muonTelescope/docs/images/frame/step8 rotated.png

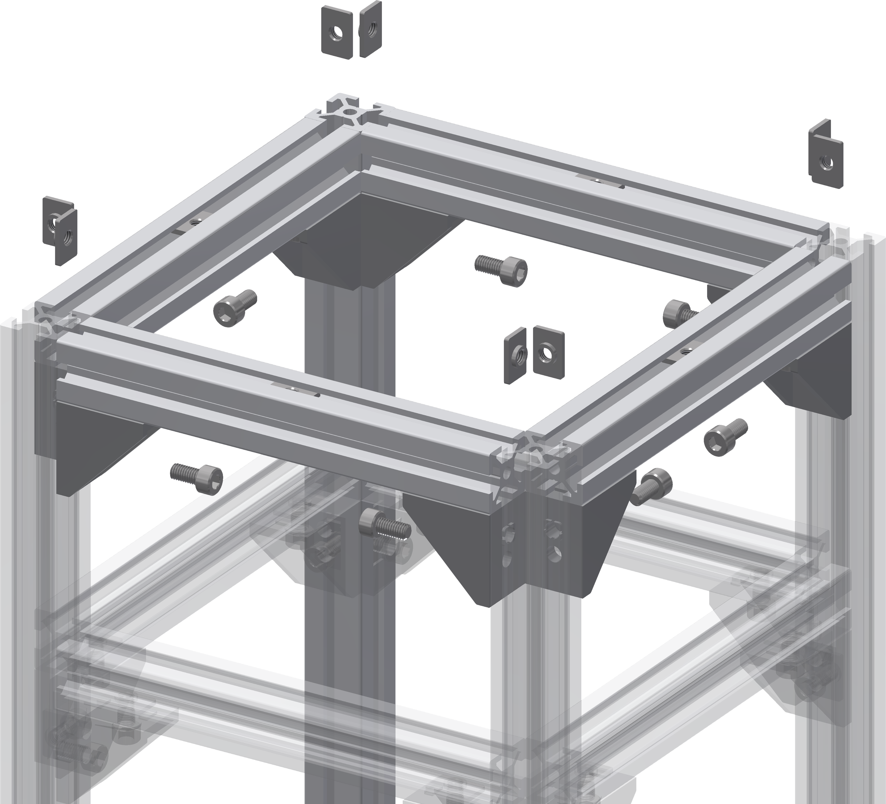
images/frame/step8 rotated.png
