muonTelescope/docs/images/frame/step10feet.png

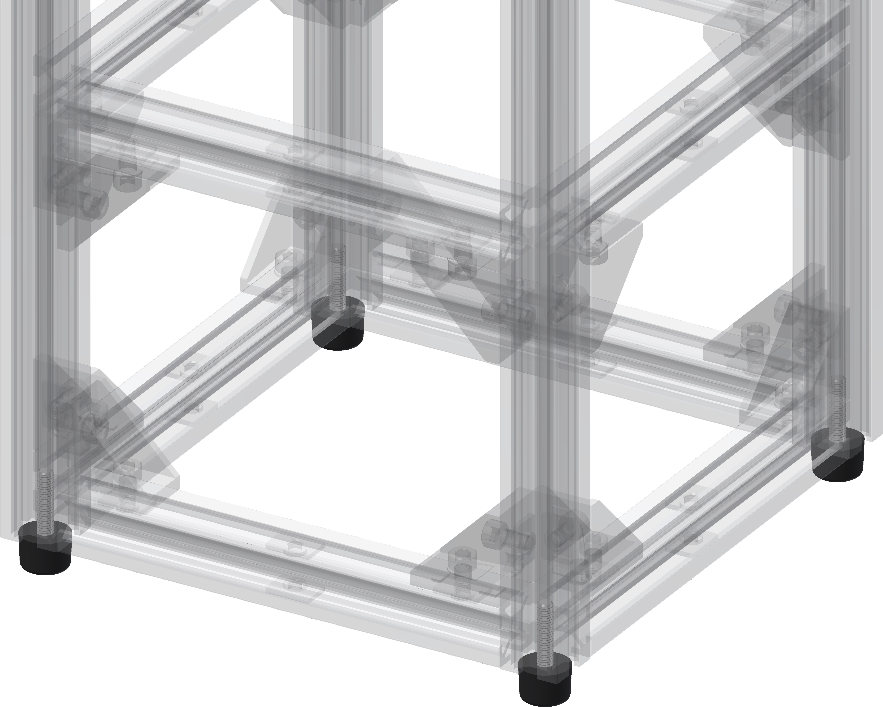
images/frame/step10feet.png
