muonTelescope/docs/tex/devTools/devTools.tex

\section{Development Tools}
The minimalist software pacakage possible are commands that can print out raw data to the terminal. The \href{https://github.com/muonTelescope/dev-tools}{dev-tools} codebase does just that. The readme for that coves how to use it.
