muonTelescope/docs/tex/frame/frame.tex

\section{Frame}

The frame is constructed out of \SI{4}{\meter} of Misumi 2020 aluminium extrution, cast angle brackets, t-nuts, M5 screws, and rubber feet. The assembly process requires only a \SI{4}{\milli\meter} hex key.

\subsection{Construction}
The frame is designed to be easy to assembly, take apart, and modify for diffrent experiments and highly rugged. It is constructed out of metric aluminium extrution and cast aluminium angle brackets, with rubber feet at the bottom. A full bill of materials is shown in Table~\ref{tab:frameBOM}. The panels it is meant to hold fit within the $\SI{20}{\milli\meter}$ extrution hegight, and the remining area is filled ithe a soft tubing spring. The panels are supourted on both sides by $\sfrac{3}{32}$ inch acrylic sheet and a addtion panel provides a mounting location for the electronics. The assembly process requires only a \SI{4}{\milli\meter} hex key, and can be made vibration resistant through the application of threadlocker (blue color code). 

\begin{table}[h]
    \centering
    \begin{adjustbox}{width=\textwidth,center}
        \begin{tabular}{ l  l  l  r  r  r }
            \multicolumn{6}{ c }{Bill of Materials} \\
            \hline
            \textbf{Description} & \textbf{Item} & \textbf{Supplier} & \textbf{QTY} & \textbf{Unit} & \textbf{Ext} \\ \hline \hline
            \product{Aluminium Extrustion}{\href{https://us.misumi-ec.com/vona2/detail/110302683830/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}{\texttt{KHFS5-2020-1000}}}{Misumi}{4}{6.41}{25.64}
            \product{Angle Brackets}{\href{https://us.misumi-ec.com/vona2/detail/110300437260/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}{\texttt{HBLFSNF5}}}{Misumi}{64}{0.63}{40.32}
            \product{M5 T-Nuts}{\href{https://us.misumi-ec.com/vona2/detail/110302246940/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}{\texttt{HNKK5-5}}}{Misumi}{$\sfrac{156}{100}$}{15.26}{23.81}
            \product{M5x6}{\href{https://www.mcmaster.com/91292a189}{\texttt{91292a189}}}{McMaster-Carr}{$\sfrac{28}{50}$}{4.63}{2.59}
            \product{M5x10}{\href{https://www.mcmaster.com/91292a124}{\texttt{91292A124}}}{McMaster-Carr}{$\sfrac{128}{100}$}{8.15}{11.20}
            \product{M5x25}{\href{https://www.mcmaster.com/91292a129}{\texttt{91292a129}}}{McMaster-Carr}{$\sfrac{4}{25}$}{6.85}{1.10}
            \product{Acrylic Sheet}{\href{https://www.mcmaster.com/8560k182}{\texttt{8560k182}}}{McMaster-Carr}{$\sfrac{7}{6}$}{8.96}{10.45}
            \product{Rubber Feet}{\href{https://www.mcmaster.com/9540K717}{\texttt{9540K717}}}{McMaster-Carr}{$\sfrac{4}{25}$}{7.42}{1.19}
            \hline
            \product{Labor}{}{}{2}{30.00}{60.00}
            \hline
            \multicolumn{5}{r}{\textbf{Subtotal}} & XXX.XX \\
            \multicolumn{5}{r}{\textbf{Tax}} & \%8.000 \\
            \multicolumn{5}{r}{\textbf{Transport}} & \%XX.XX \\
            \multicolumn{5}{r}{\textbf{Total (USD)}} & 189.24 \\
        \end{tabular}
    \end{adjustbox}
    \caption{Materials required for one frame.}
    \label{tab:frameBOM}
\end{table}

\begin{table}[h]
    \centering
    \begin{adjustbox}{width=\textwidth,center}
        \begin{tabular}{ l r r l }
            \multicolumn{4}{ c }{Aluminum Extrustion Cut List} \\
            \hline
            \textbf{Description} & \textbf{QTY} & \textbf{Length (mm)} & \textbf{Note}\\ \hline \hline
            Vertical Beam        & 4            & 396                  & M5 thread tapped one end \SI{20}{\milli\meter} deep\\
            Horizontal Beam      & 16           & 150 \\
        \end{tabular}
    \end{adjustbox}
    \caption{One vertical and four horizontal to be cut from each \SI{1}{\meter} section. \SI{1}{\milli\meter} kerf.}    
    \label{tab:cutList}
\end{table}

\subsubsection{Assembly}
Insert assembly PDF output form Illistrator

\pagebreak
