muonTelescope/docs/images/frame/16x.png

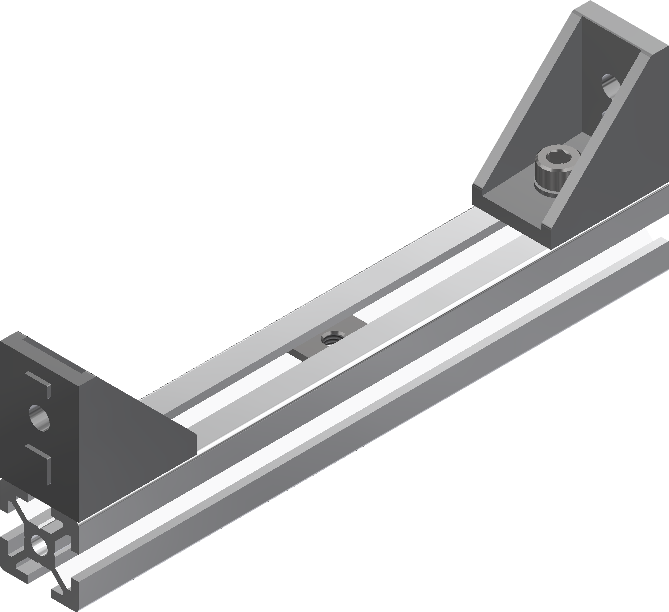
images/frame/16x.png
