muonTelescope/docs/images/frame/150mm.png

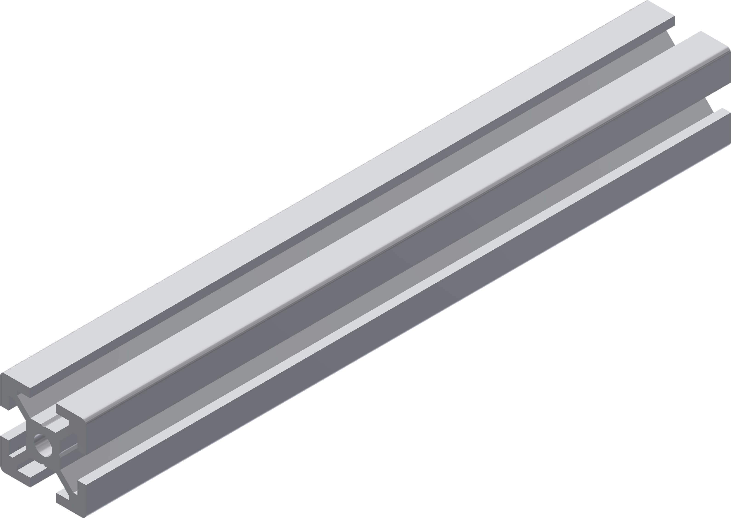
images/frame/150mm.png
