muonTelescope/docs/images/frame/400mm.png

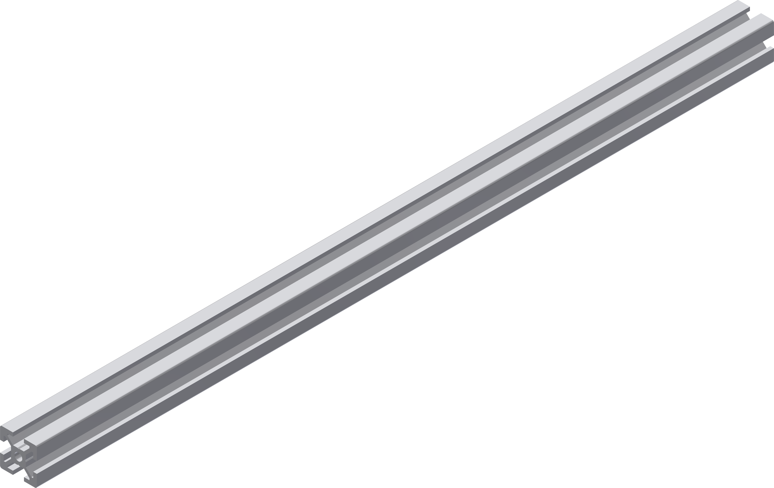
images/frame/400mm.png
