muonTelescope/docs/images/frame/angleBracket.png

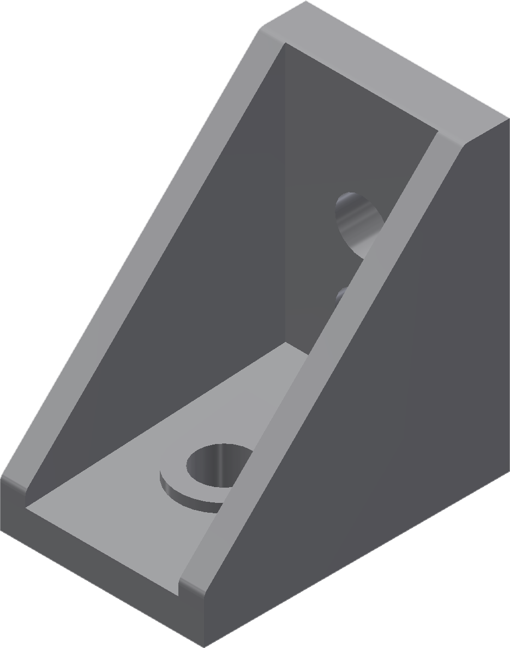
images/frame/angleBracket.png
