muonTelescope/docs/images/frame/m5x6.png

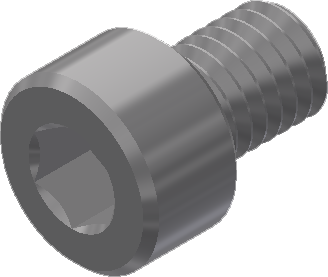
images/frame/m5x6.png
