muonTelescope/docs/images/frame/m5x10.png

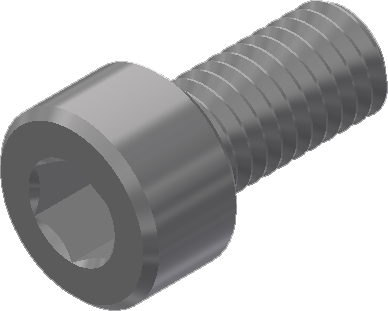
images/frame/m5x10.png
