muonTelescope/docs/images/frame/m5x25.png

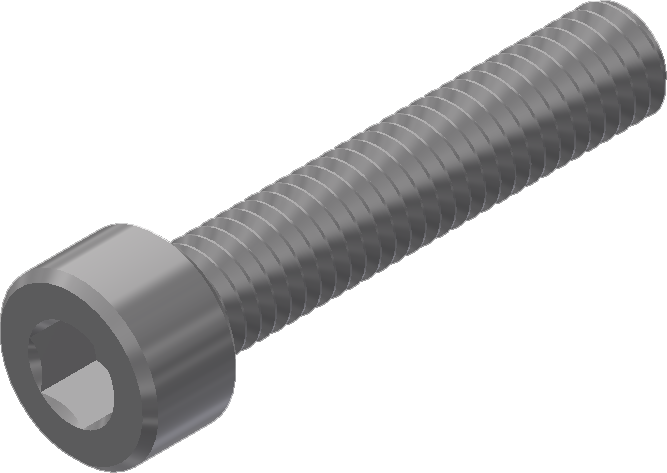
images/frame/m5x25.png
