muonTelescope/docs/images/frame/rubberFoot.png

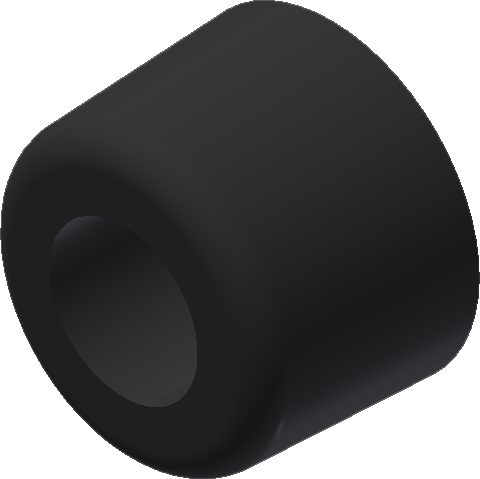
images/frame/rubberFoot.png
