muonTelescope/docs/images/frame/t-nut.png

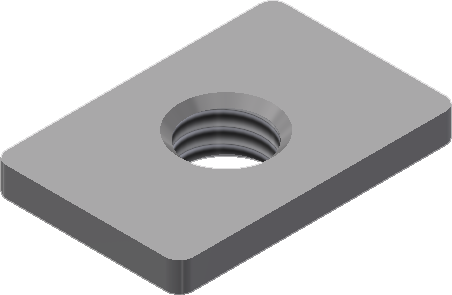
images/frame/t-nut.png
