muonTelescope/docs/images/frame/tools.png

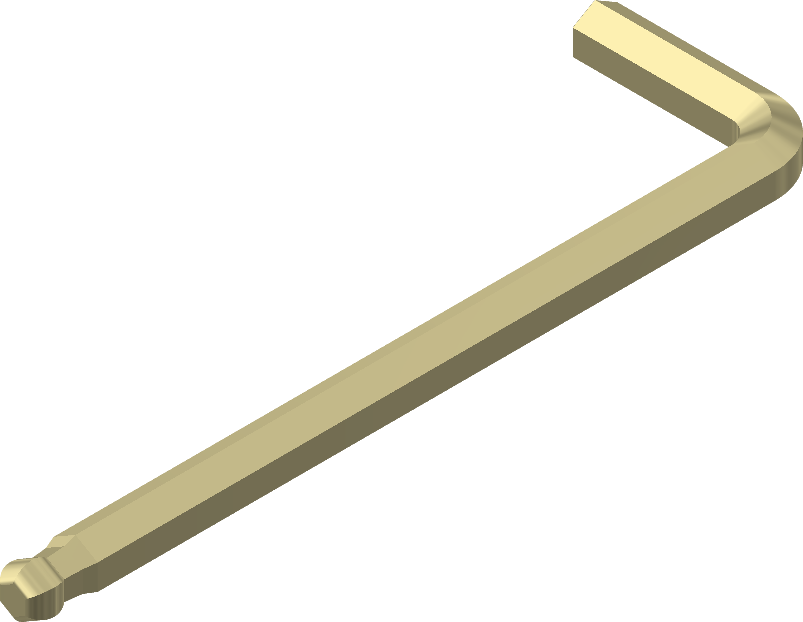
images/frame/tools.png
