muonTelescope/docs/images/mppcInterfaceDocs/11mm standoff.png

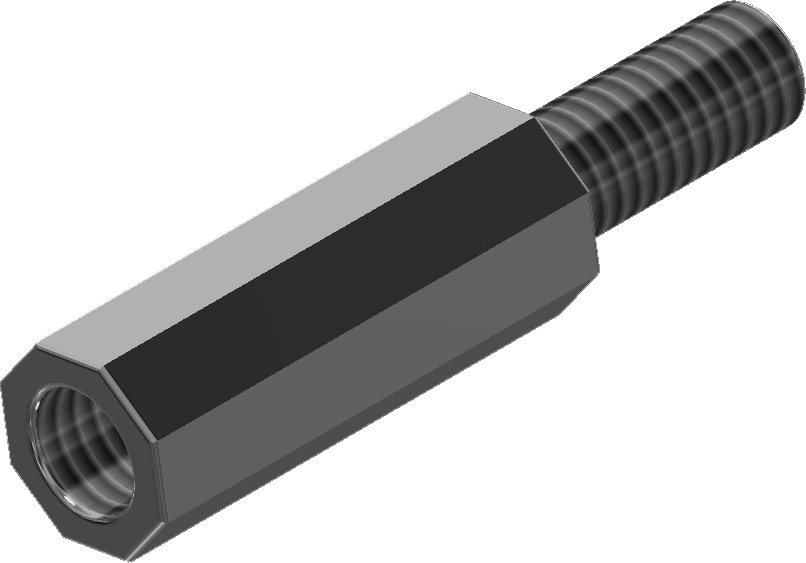
images/mppcInterfaceDocs/11mm standoff.png
