muonTelescope/docs/images/mppcInterfaceDocs/m2.5.png

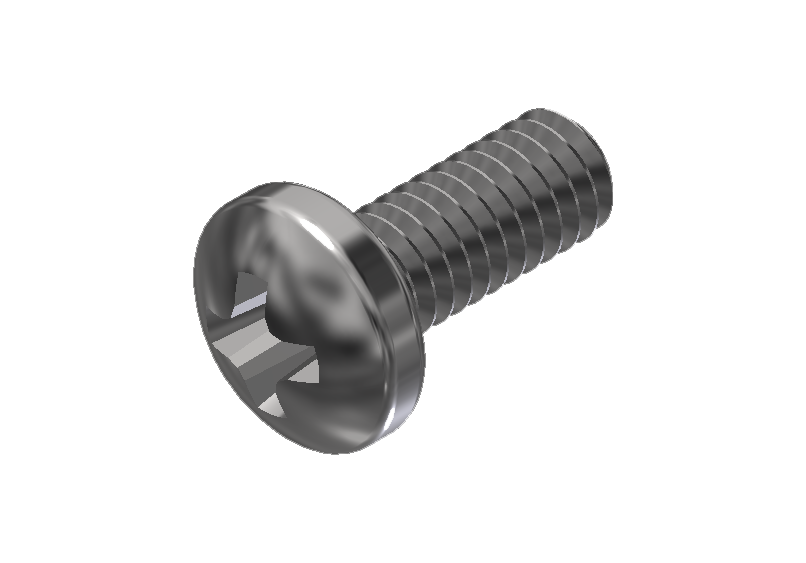
images/mppcInterfaceDocs/m2.5.png
