muonTelescope/docs/images/mppcInterfaceDocs/mppcInterfacePart.png

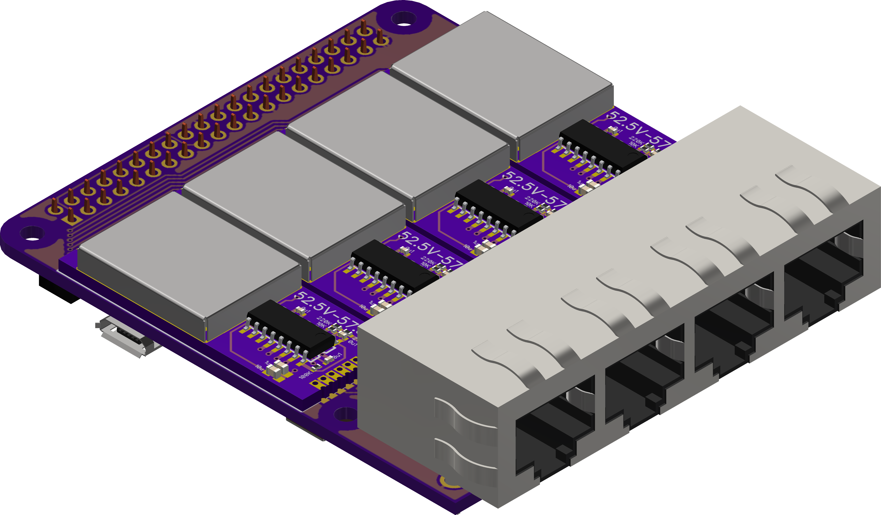
images/mppcInterfaceDocs/mppcInterfacePart.png
