muonTelescope/docs/images/mppcInterfaceDocs/mppcInterfaceSheildAttach.png

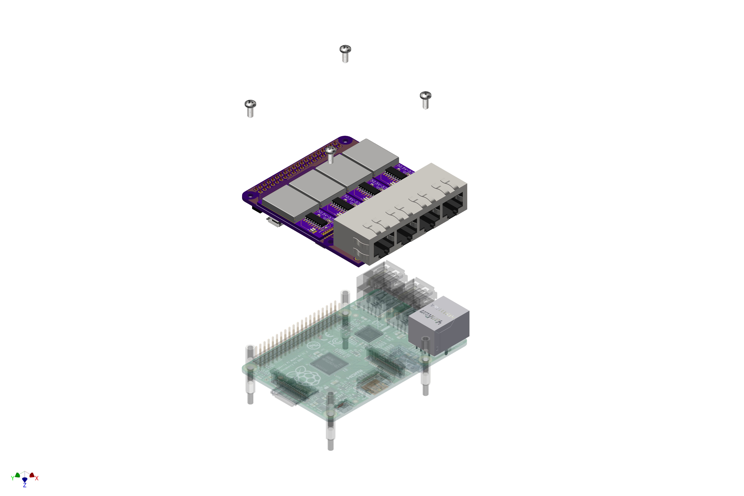
images/mppcInterfaceDocs/mppcInterfaceSheildAttach.png
