muonTelescope/docs/images/mppcInterfaceDocs/mppcInterfaceSubmodule.png

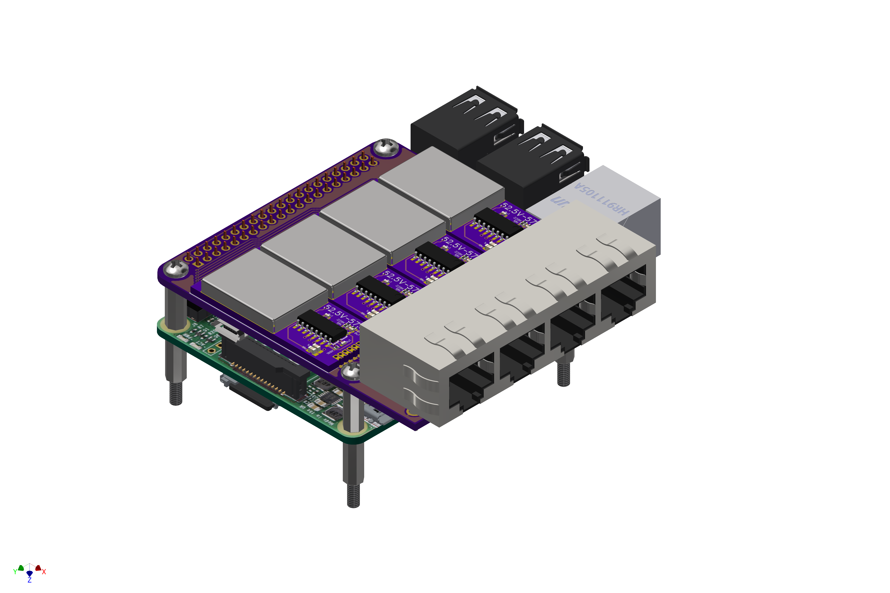
images/mppcInterfaceDocs/mppcInterfaceSubmodule.png
