muonTelescope/docs/images/mppcSensor/mppcSensorPinout-01.png

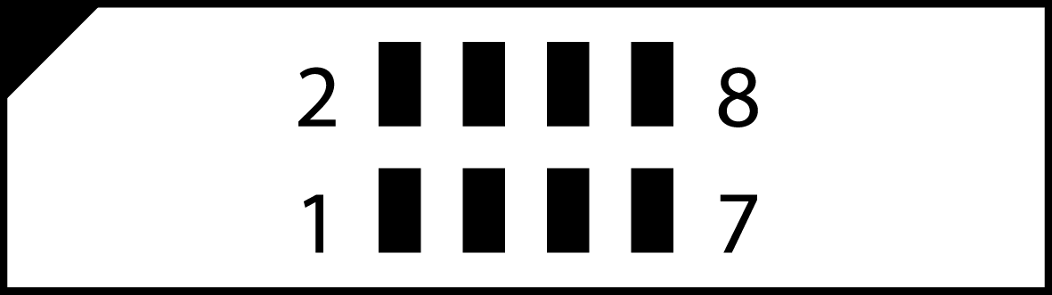
images/mppcSensor/mppcSensorPinout-01.png
