muonTelescope/docs/tex/mppcHighVoltage/img/errorFromDesign.png

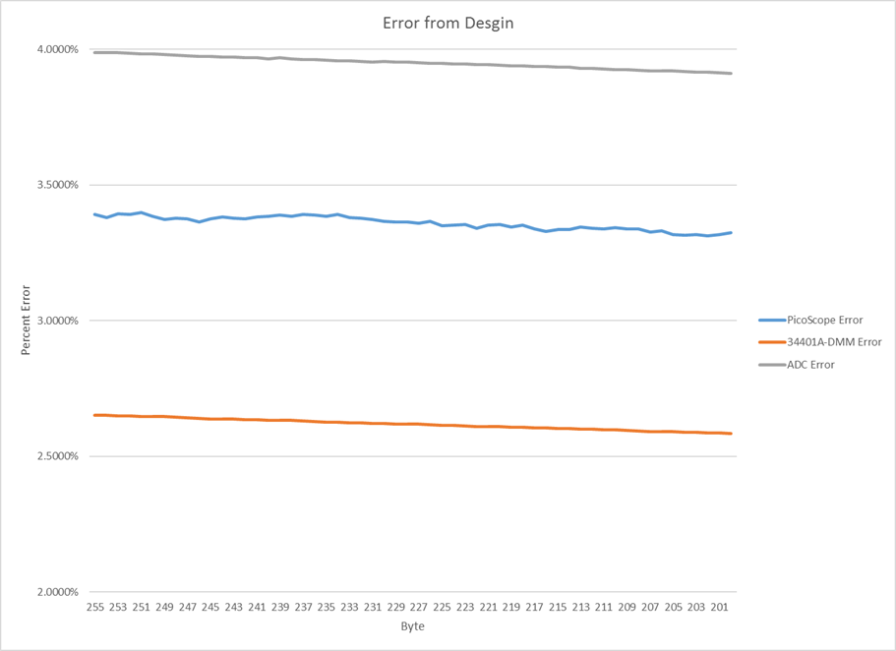
tex/mppcHighVoltage/img/errorFromDesign.png
