muonTelescope/docs/tex/mppcHighVoltage/img/hvSchematic.jpg

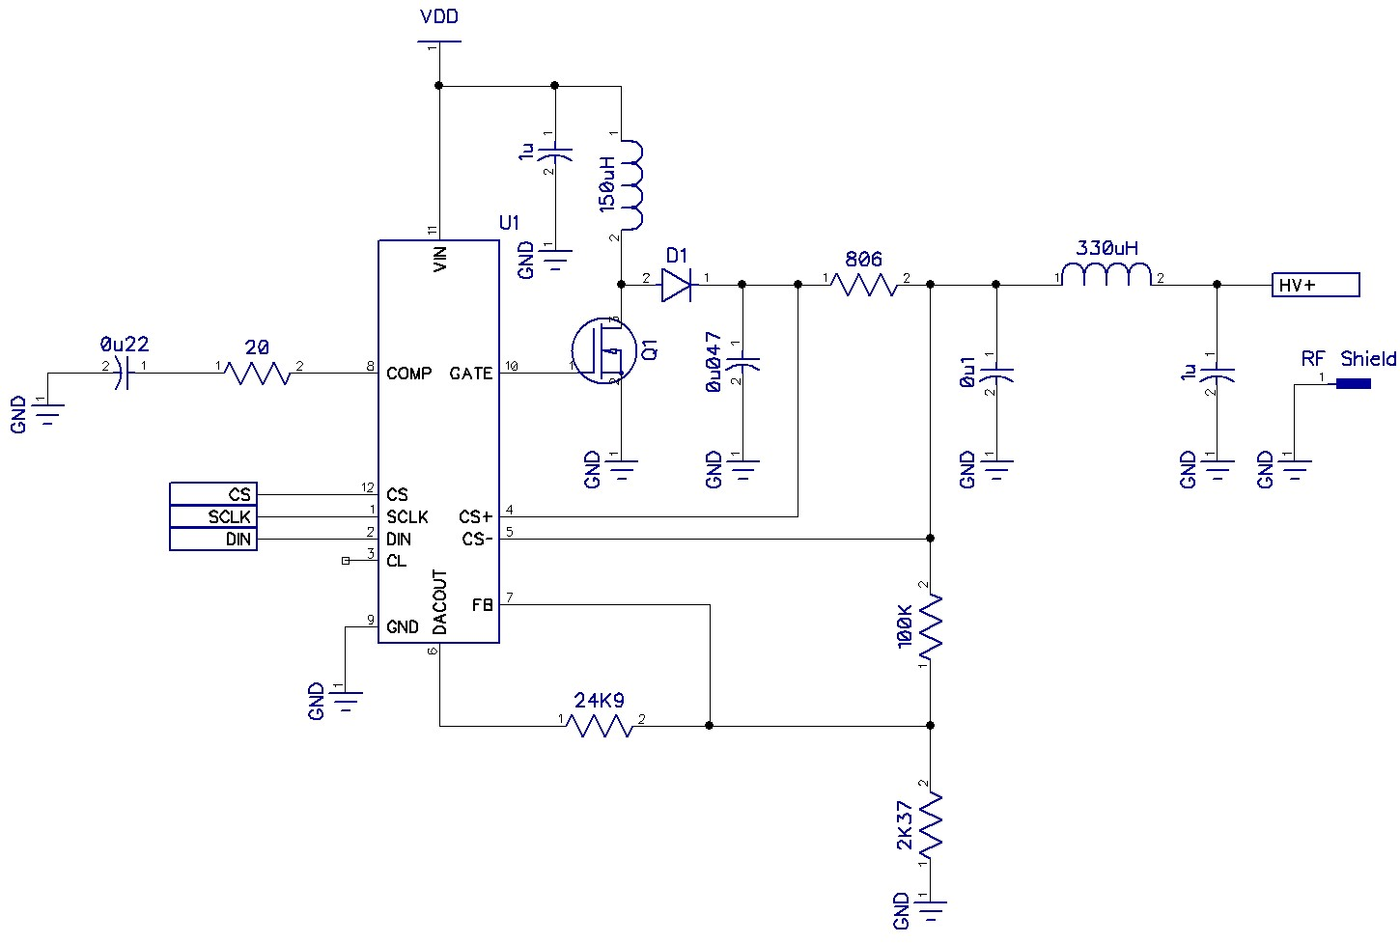
tex/mppcHighVoltage/img/hvSchematic.jpg
