muonTelescope/docs/tex/mppcHighVoltage/img/voltageVsByte.png

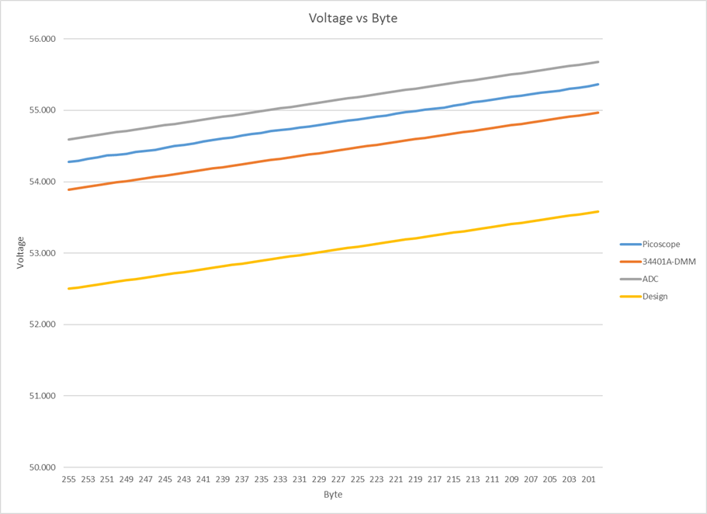
tex/mppcHighVoltage/img/voltageVsByte.png
