muonTelescope/docs/tex/mppcSensor/img/connectorsSchematic.jpg

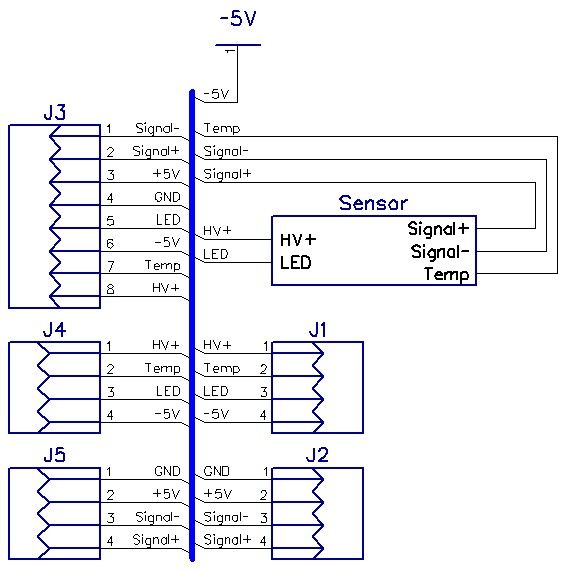
tex/mppcSensor/img/connectorsSchematic.jpg
