muonTelescope/docs/tex/mppcSensor/img/sensorSchematic.jpg

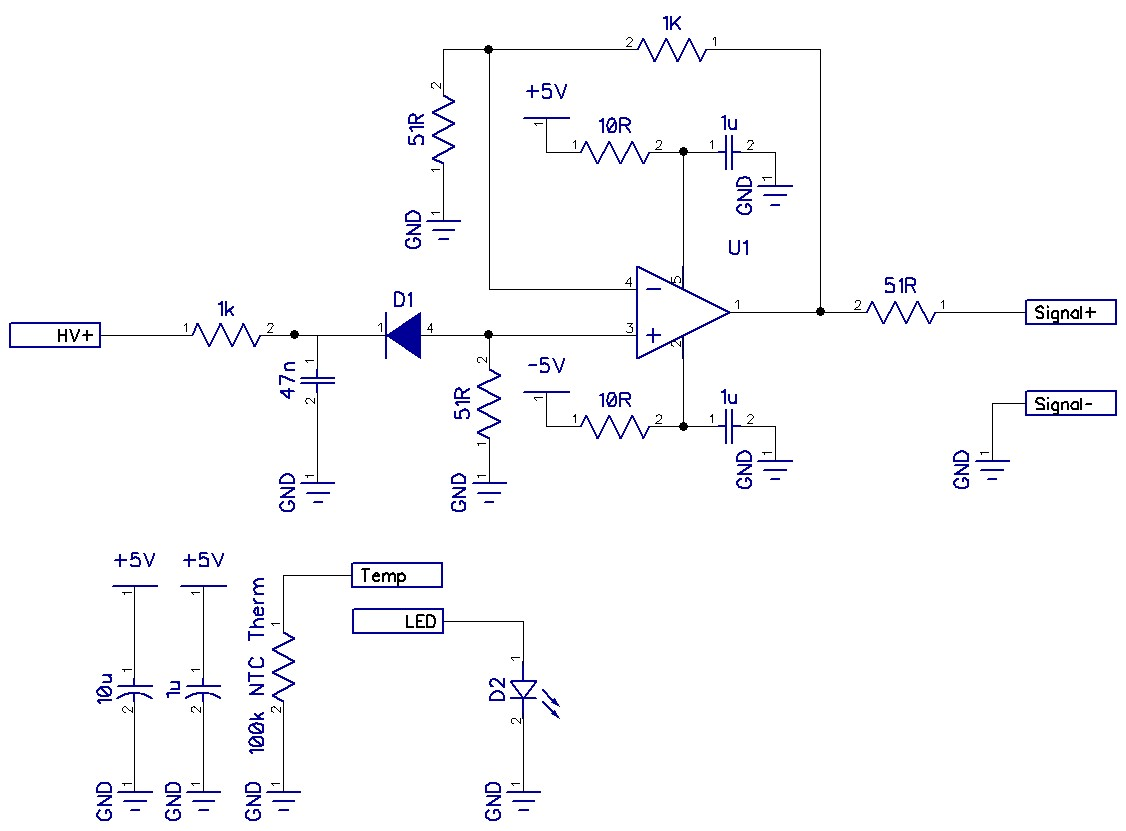
tex/mppcSensor/img/sensorSchematic.jpg
