muonTelescope/docs/images/frame/parts.png

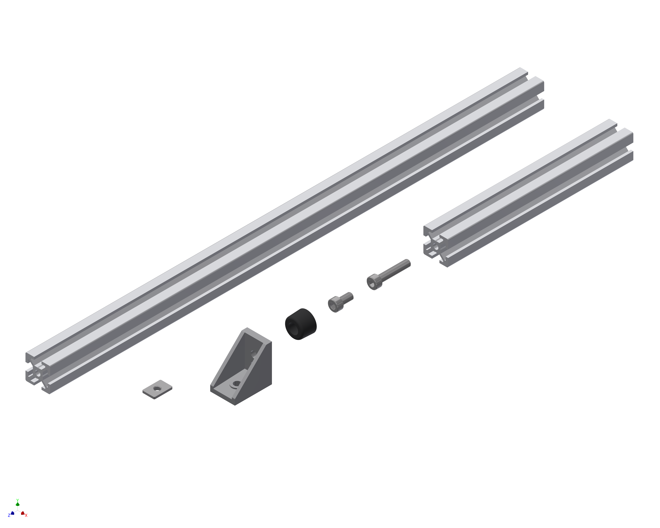
images/frame/parts.png
