muonTelescope/docs/tex/assembly/assembly.tex

\includepdf[pages={ - }]{./tex/assembly/mppcInterfaceAssembly.pdf}
\includepdf[pages={ - }]{./tex/assembly/frameAssembly.pdf}
