muonTelescope/docs/tex/assembly/mppcInterfaceAssembly.pdf

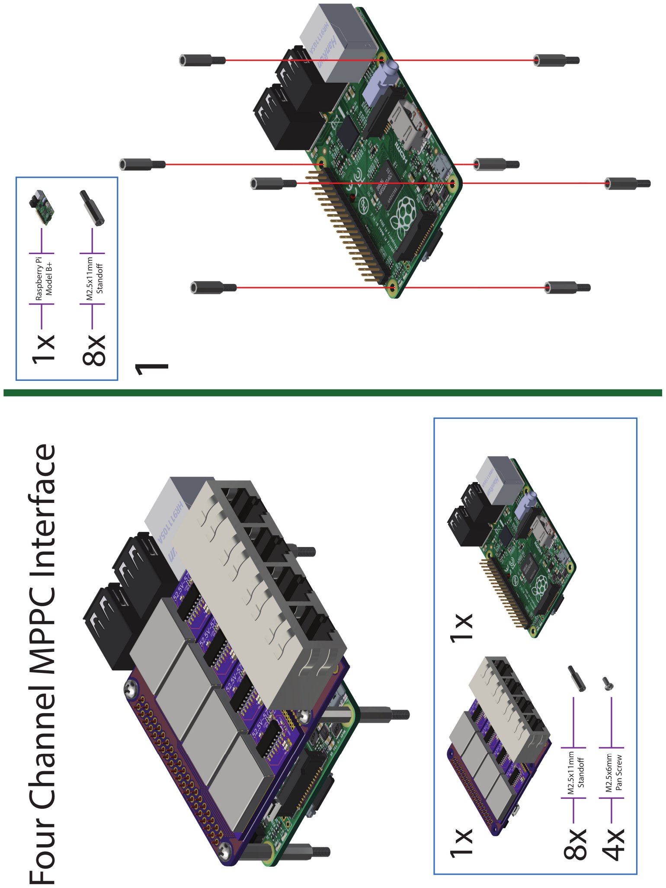
[picture p25: page 1]
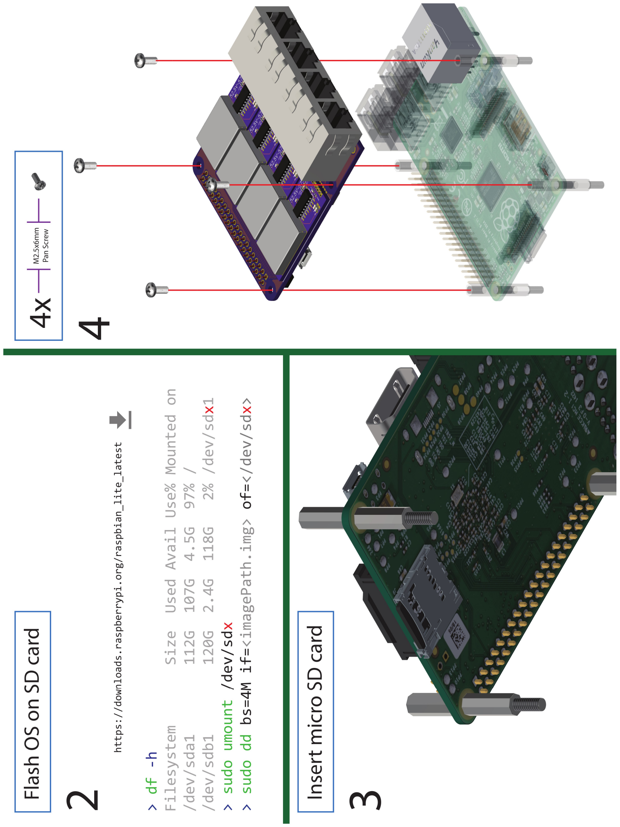
[picture p26: page 2]
