muonTelescope/docs/images/assembled2.png

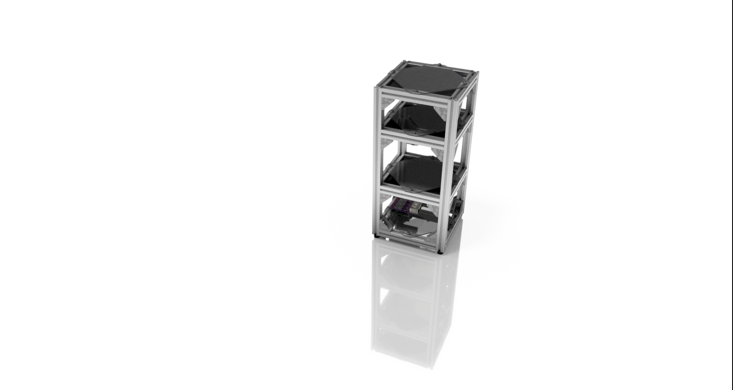
images/assembled2.png
