muonTelescope/docs/images/frame/step1.png

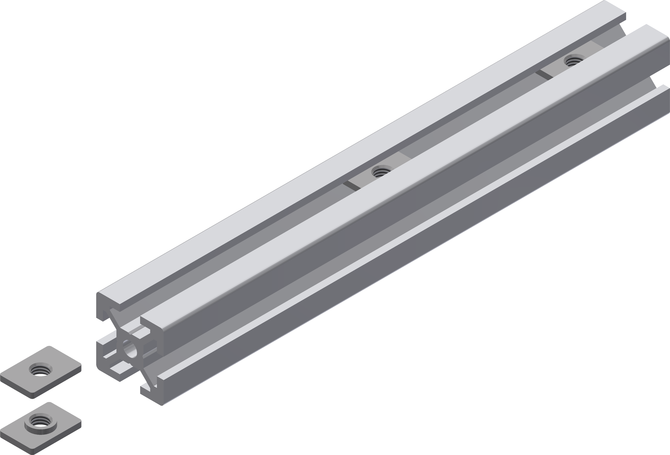
images/frame/step1.png
