muonTelescope/docs/images/frame/step2.png

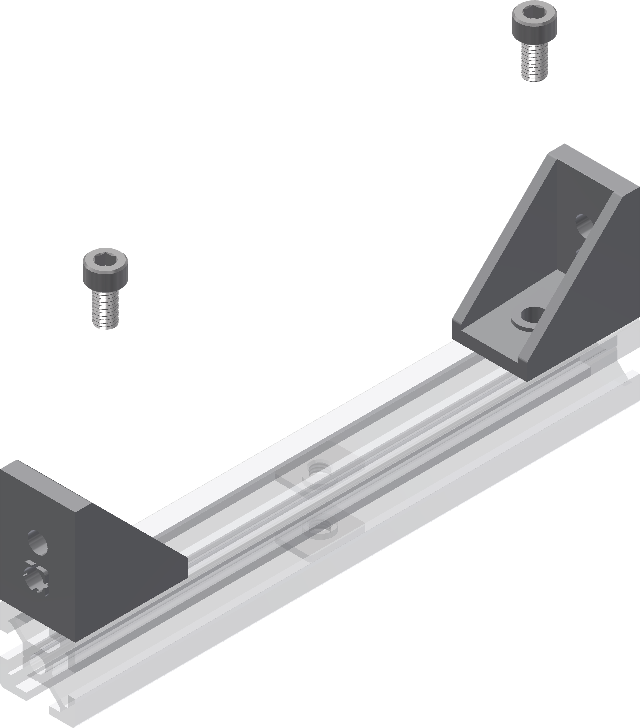
images/frame/step2.png
