muonTelescope/docs/images/frame/step3.png

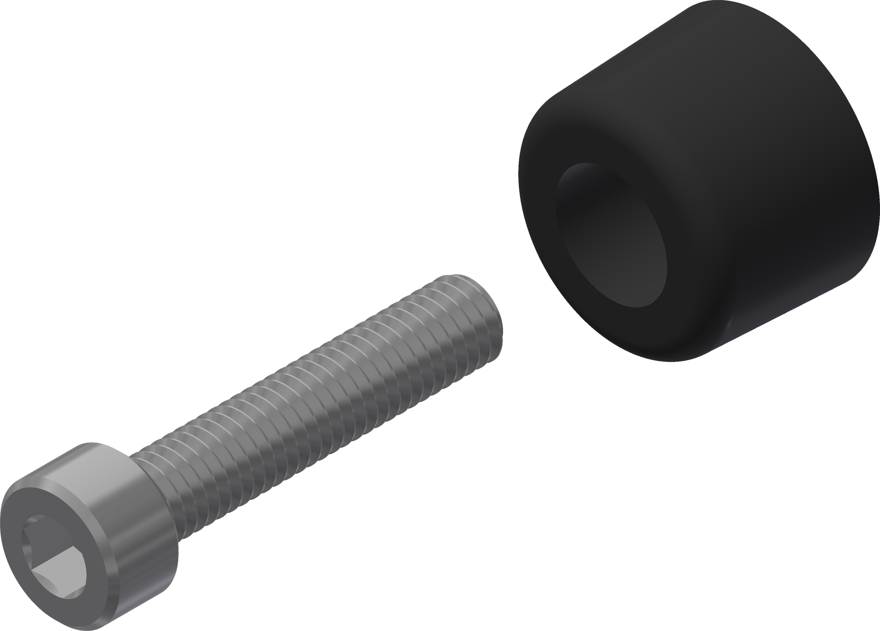
images/frame/step3.png
