muonTelescope/docs/images/frame/step4 detail.png

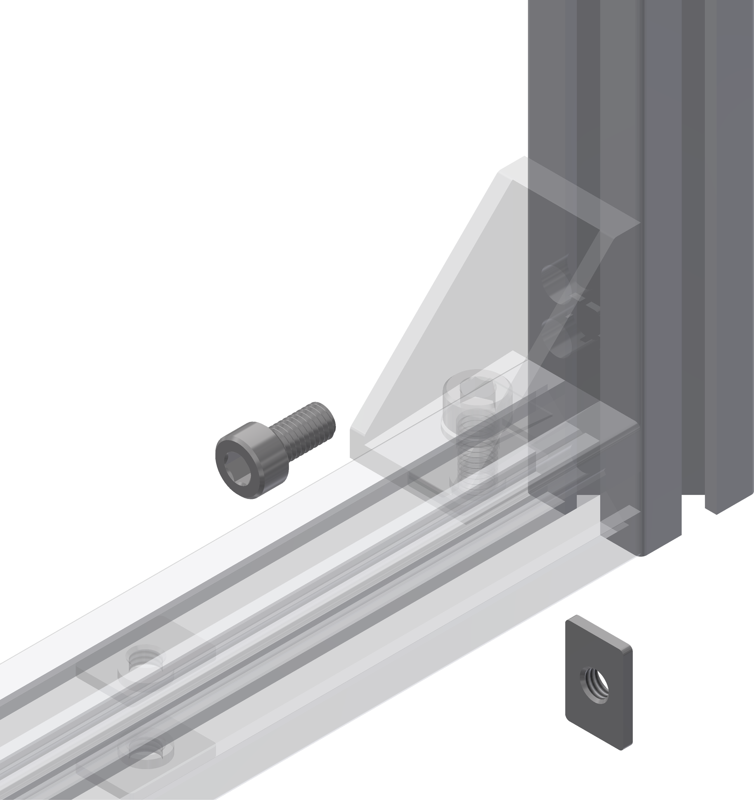
images/frame/step4 detail.png
