muonTelescope/docs/images/frame/step4.png

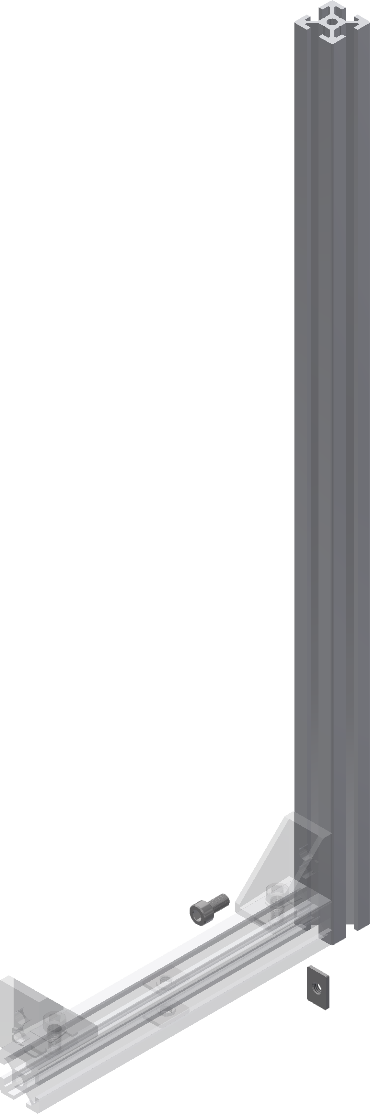
images/frame/step4.png
