muonTelescope/docs/images/frame/step5.png

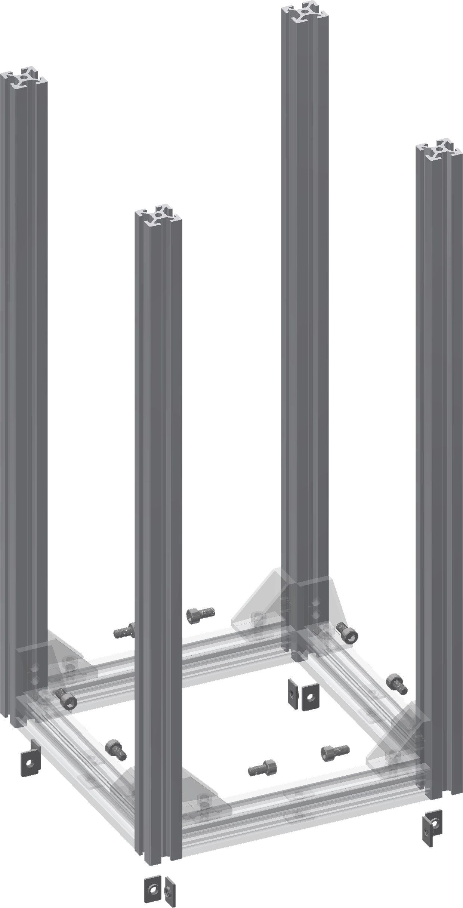
images/frame/step5.png
