muonTelescope/docs/images/frame/step5detail.png

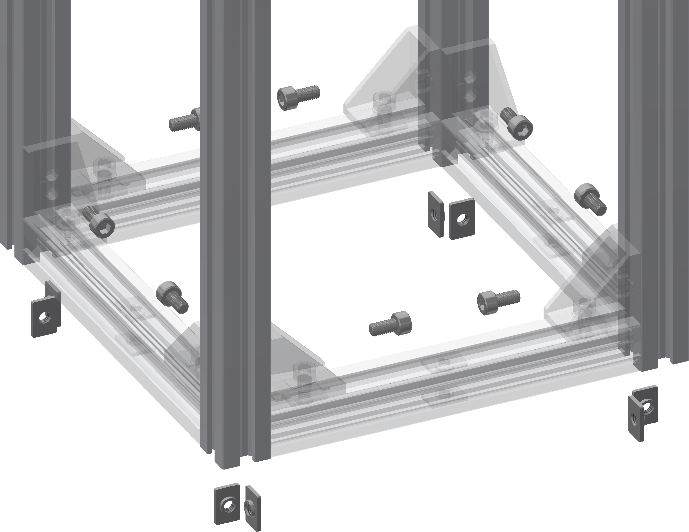
images/frame/step5detail.png
