muonTelescope/docs/images/frame/step6.png

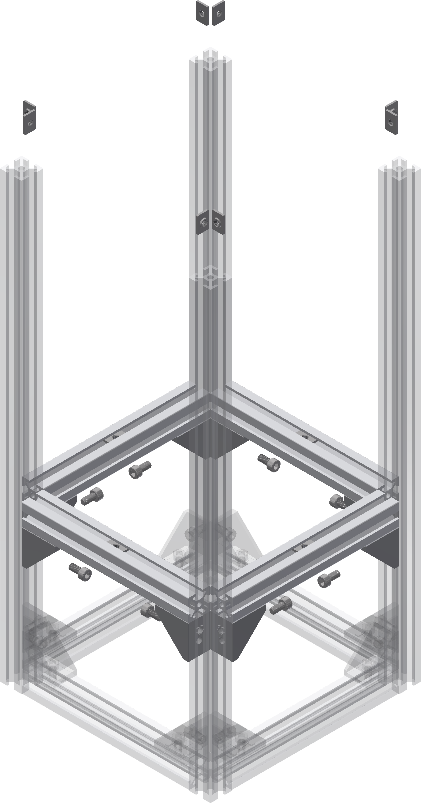
images/frame/step6.png
