muonTelescope/docs/images/frame/step7.png

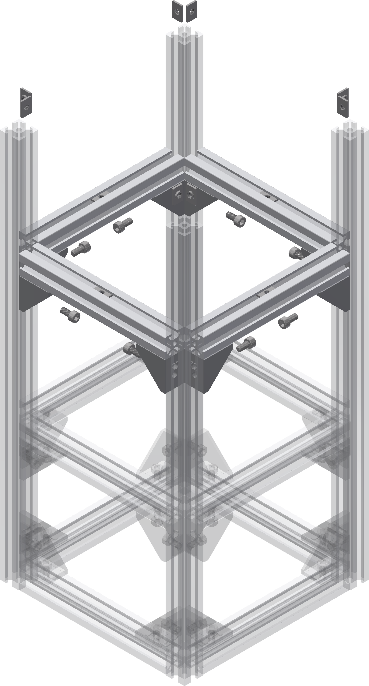
images/frame/step7.png
