muonTelescope/docs/images/frame/step8 ortho.png

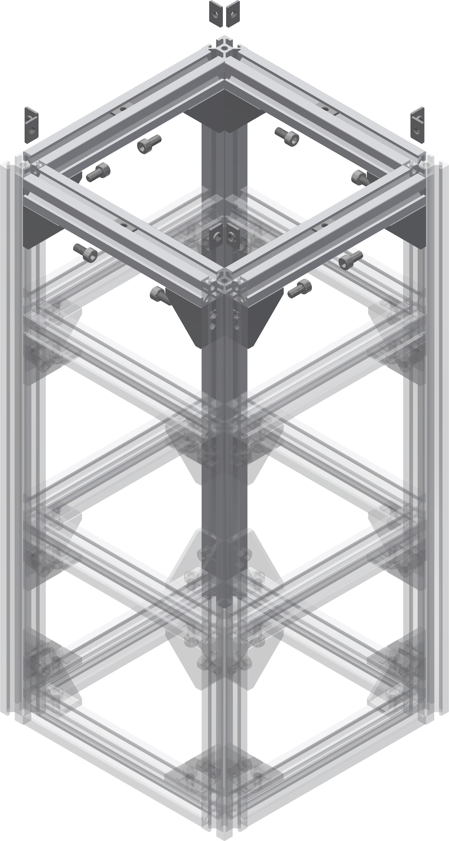
images/frame/step8 ortho.png
