muonTelescope/docs/images/frame/step9.png

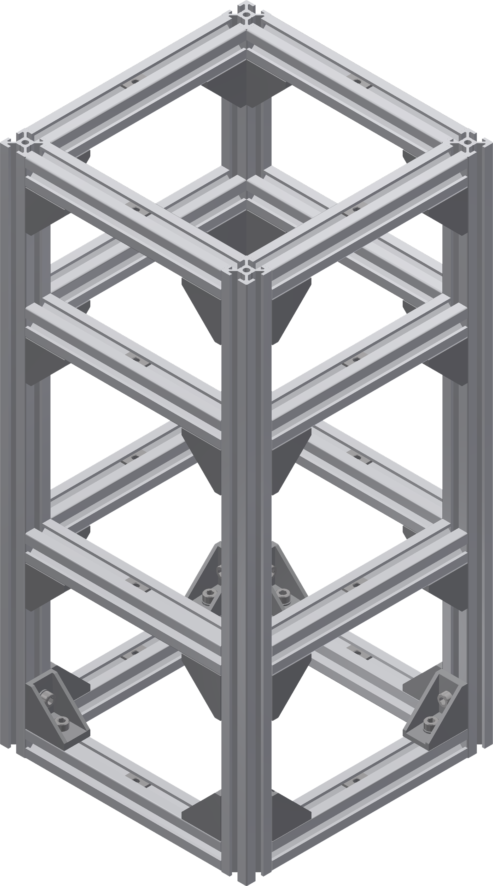
images/frame/step9.png
