muonTelescope/docs/images/frame/step10.png

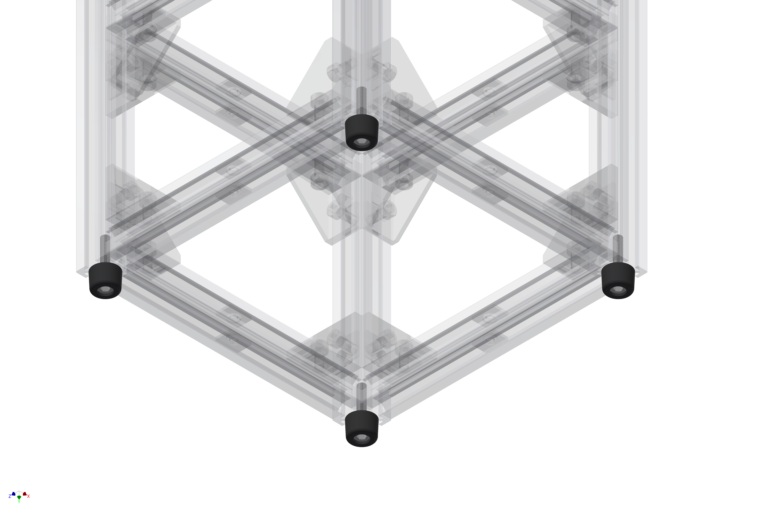
images/frame/step10.png
