muonTelescope/docs/images/frame/step10Inserting.png

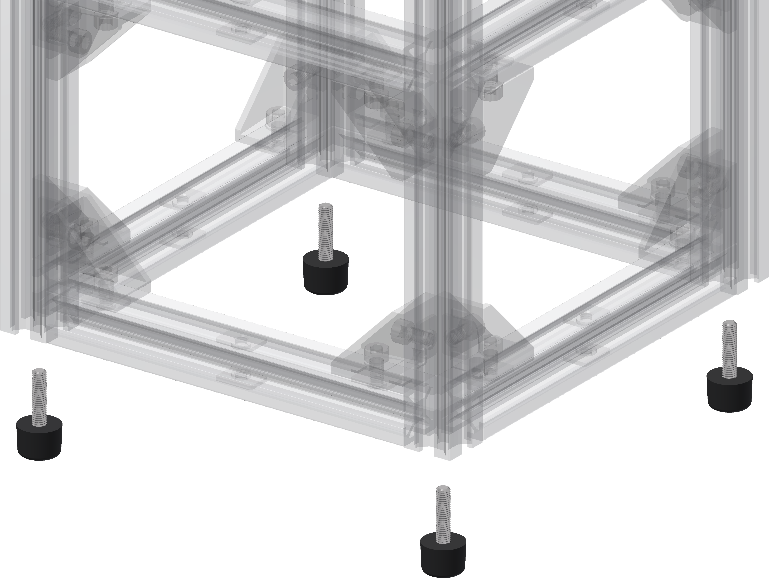
images/frame/step10Inserting.png
