muonTelescope/docs/images/mppcInterfaceDocs/mppcInterfaceAssembly.png

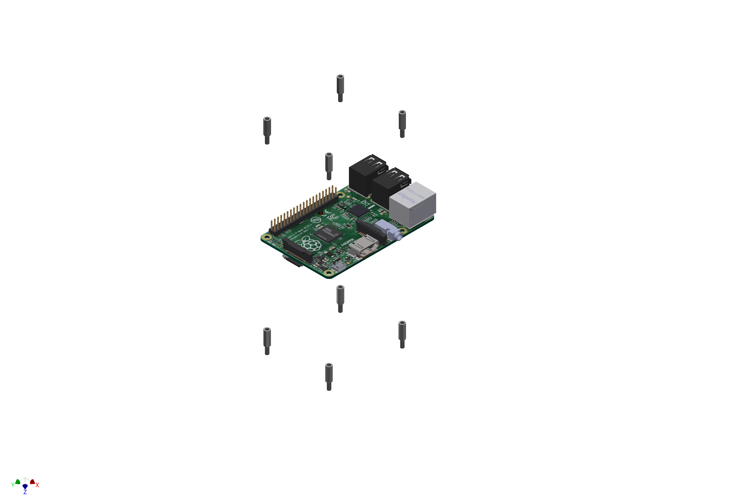
images/mppcInterfaceDocs/mppcInterfaceAssembly.png
