muonTelescope/docs/images/panelAssembly.png

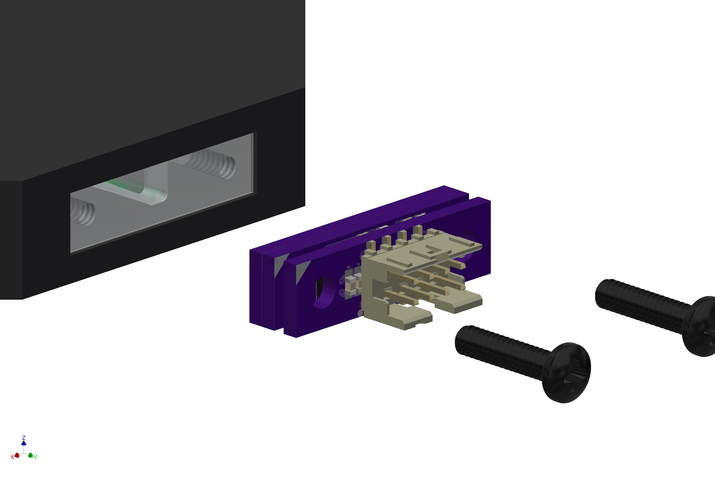
images/panelAssembly.png
