muonTelescope/docs/images/panelAssemblyAssembled.png

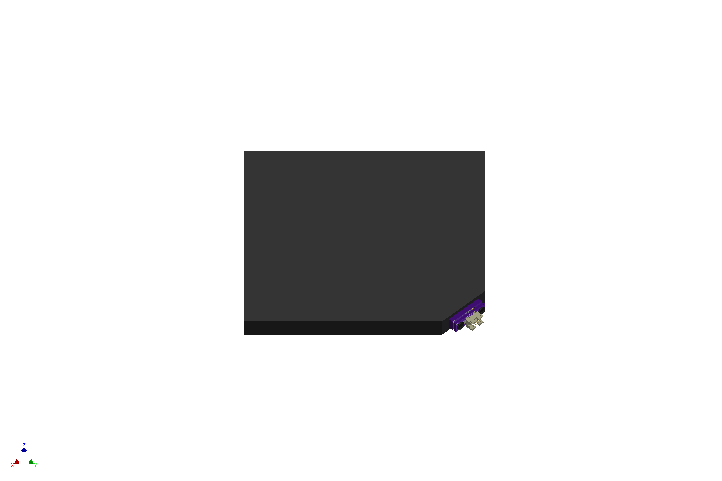
images/panelAssemblyAssembled.png
