muonTelescope/docs/images/panelAssemblyFar.png

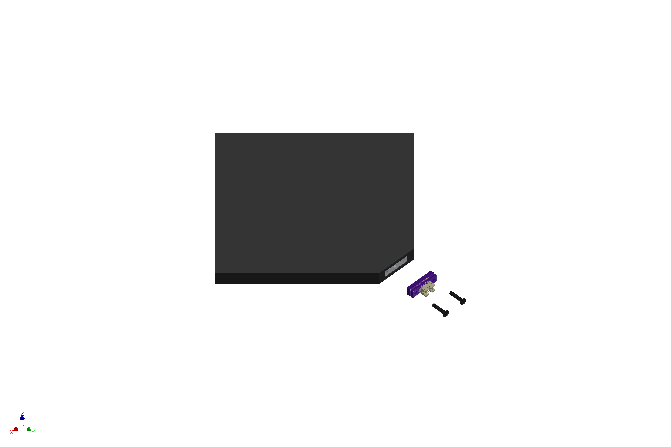
images/panelAssemblyFar.png
