muonTelescope/docs/tex/mppcHighVoltage/img/assemblySchematic.jpg

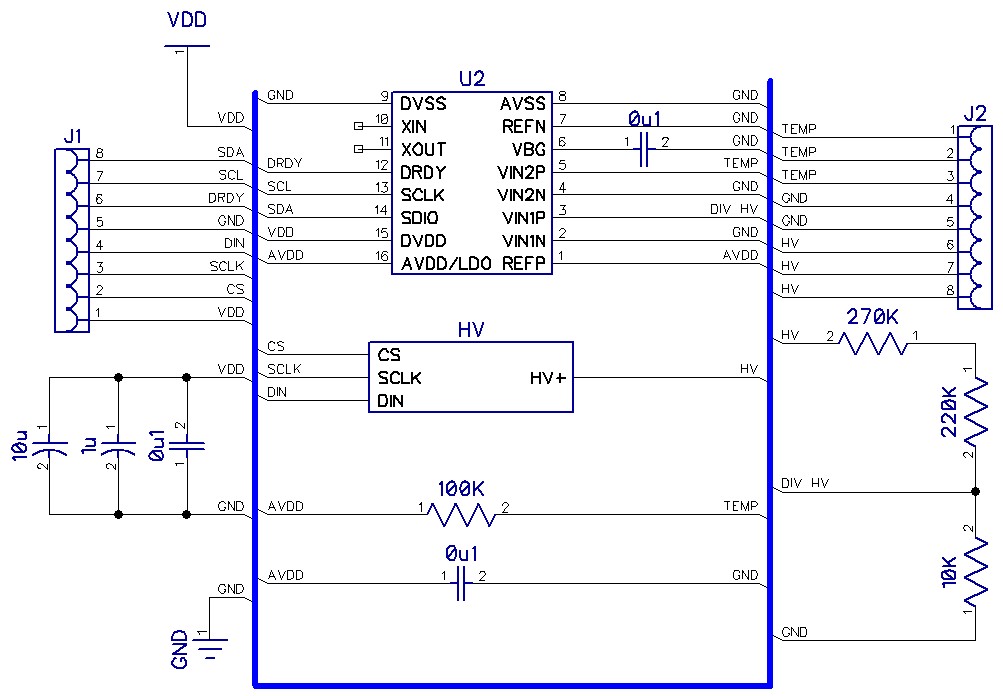
tex/mppcHighVoltage/img/assemblySchematic.jpg
